ducman1998/basket-ball-robot/images/main_state_machine.png

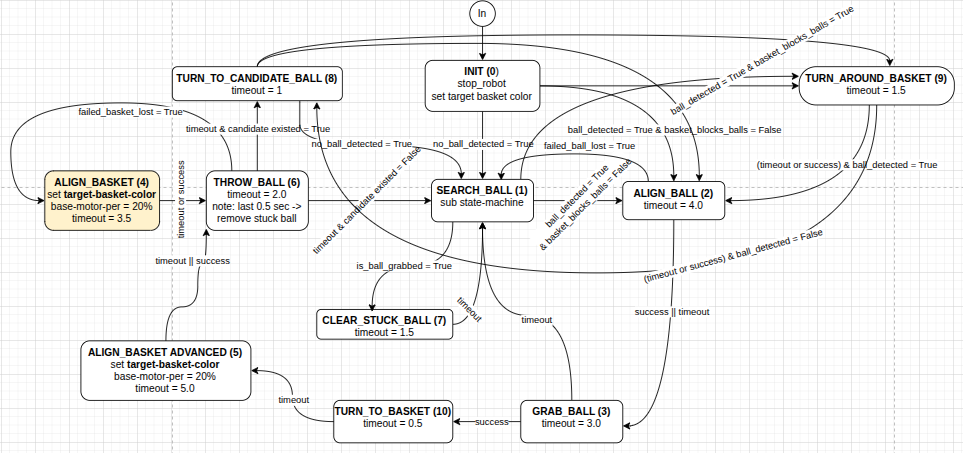
images/main_state_machine.png
