ducman1998/basket-ball-robot/images/searching_ball.png

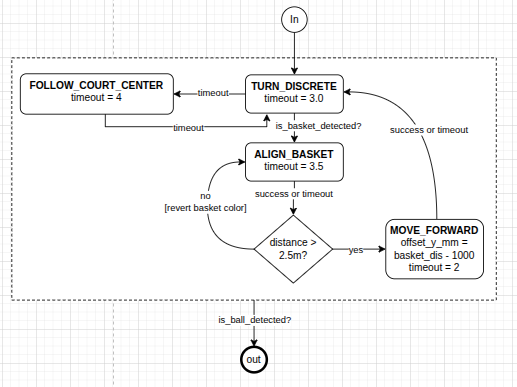
images/searching_ball.png
