ducman1998/basket-ball-robot/software/ros_nodes/src/basket_robot_nodes/basket_robot_nodes/images/robot_base_mask.png

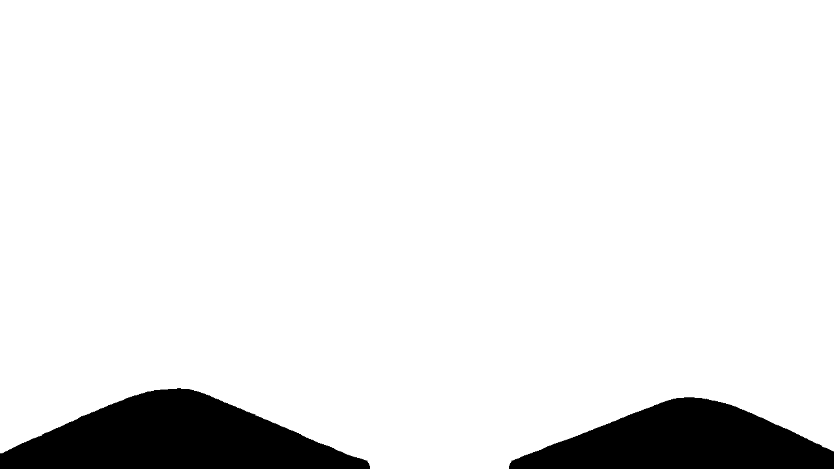
software/ros_nodes/src/basket_robot_nodes/basket_robot_nodes/images/robot_base_mask.png
