ducman1998/basket-ball-robot/electronics/picr_1_9tdi.kicad_pcb

## KiCad design electronics/picr_1_9tdi.kicad_pcb (2026-03-18)

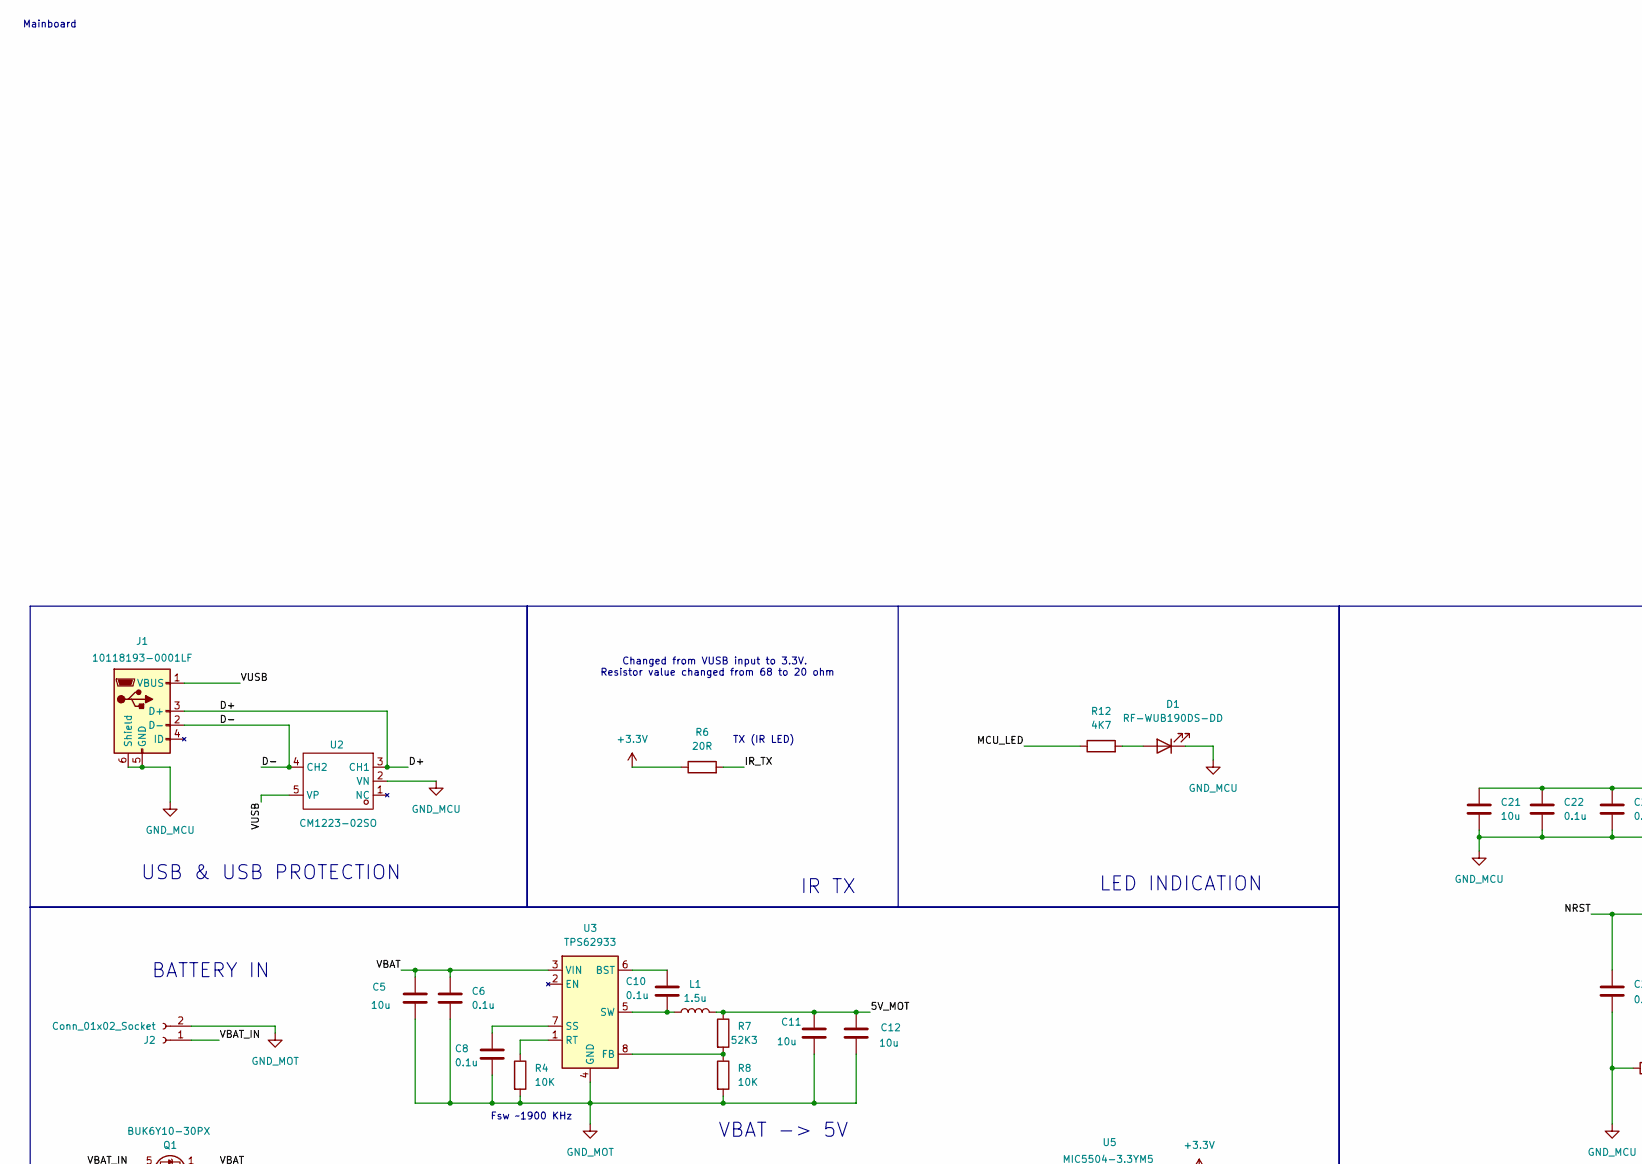
[picture p25: schematic picr_1_9tdi.kicad_sch, Mainboard & motor driver schematic, part in row 1, column 1]

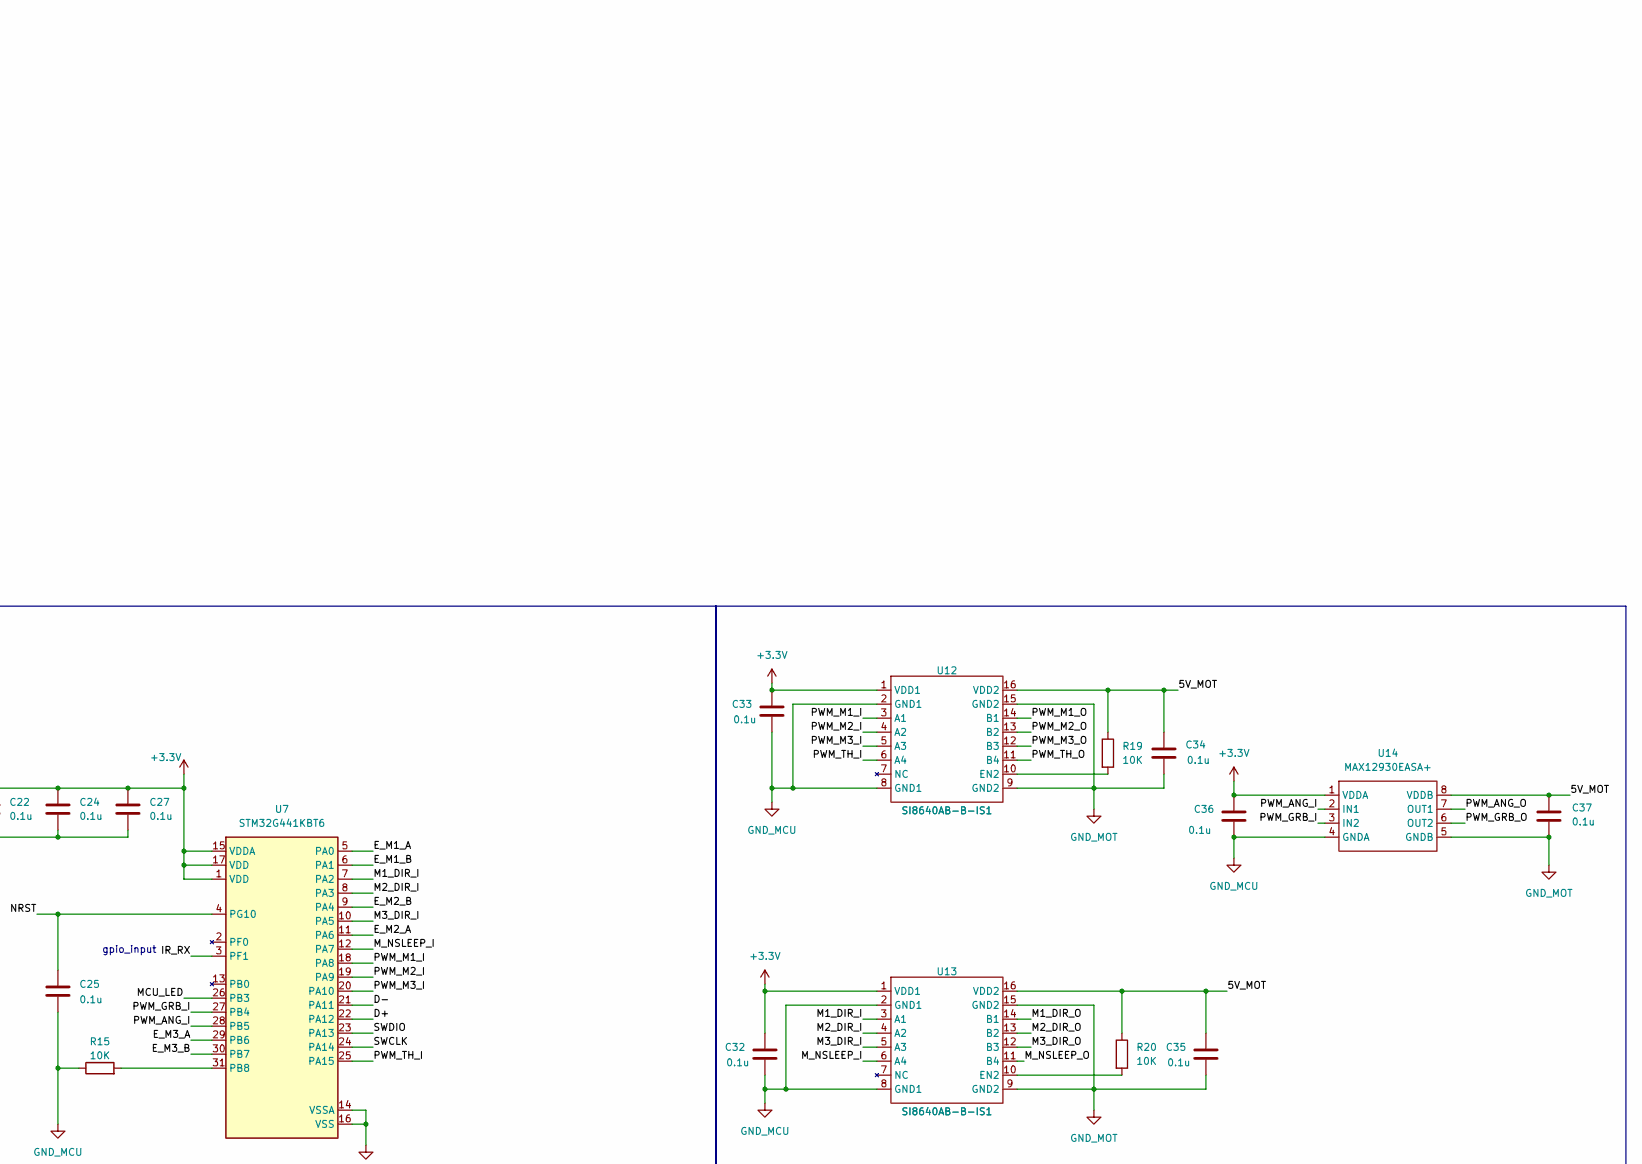
[picture p26: schematic picr_1_9tdi.kicad_sch, Mainboard & motor driver schematic, part in row 1, column 2]

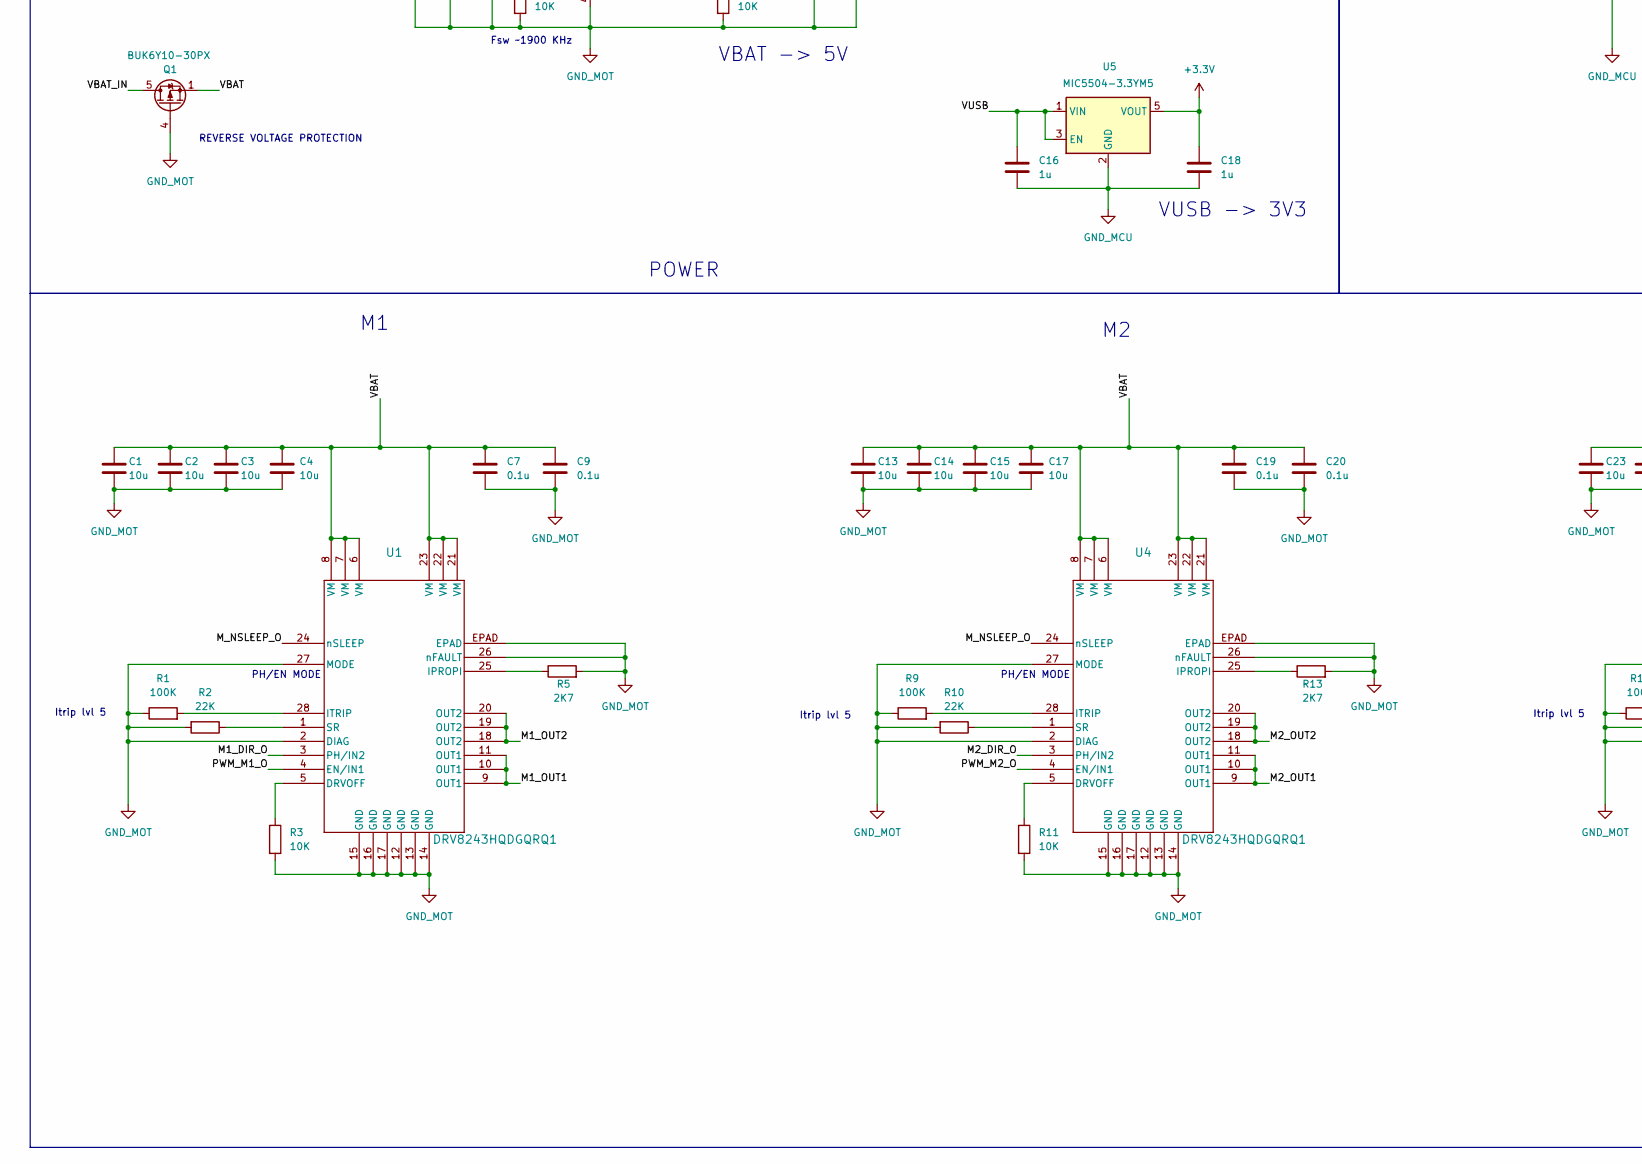
[picture p27: schematic picr_1_9tdi.kicad_sch, Mainboard & motor driver schematic, part in row 2, column 1]

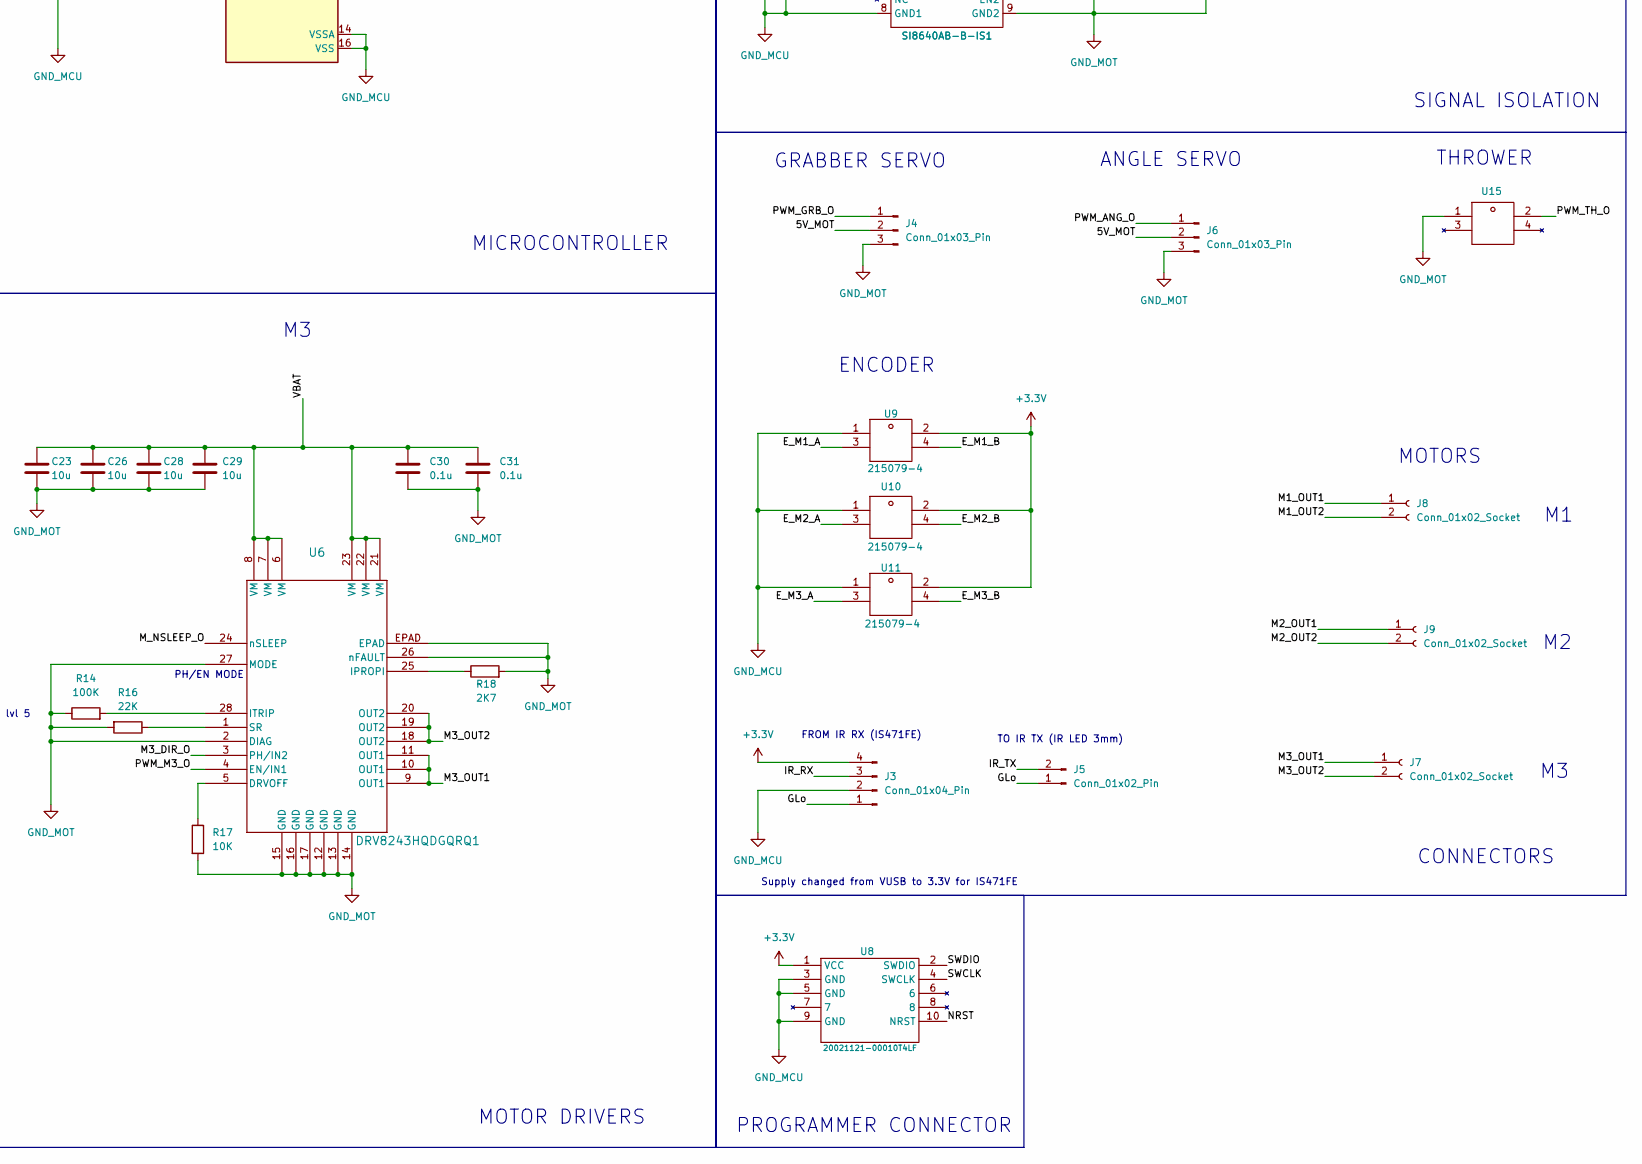
[picture p28: schematic picr_1_9tdi.kicad_sch, Mainboard & motor driver schematic, part in row 2, column 2]

Parts:
C1, C2, C3, C4, C5, C13, C14, C15, C17, C21, C23, C26, C28, C29: 10u; C_0805_2012Metric_Pad1.18x1.45mm_HandSolder
C6, C7, C8, C9, C10, C19, C20, C22, C24, C25, C27, C30, C31, C32, C33, C34, C35, C36, C37: 0.1u; C_0603_1608Metric_Pad1.08x0.95mm_HandSolder
C11, C12: 10u; C_0603_1608Metric_Pad1.08x0.95mm_HandSolder
C16, C18: 1u; C_0603_1608Metric_Pad1.08x0.95mm_HandSolder
D1: RF-WUB190DS-DD; LED_0603_1608Metric_Pad1.05x0.95mm_HandSolder
J1: 10118193-0001LF; USB_Micro-B_Amphenol_10118193-0001LF_Horizontal
J2: Conn_01x02_Socket; SolderWirePad_1x02_SMD_3x4mm_power
J3: Conn_01x04_Pin; PinHeader_1x04_P2.54mm_Vertical
J4, J6: Conn_01x03_Pin; PinHeader_1x03_P2.54mm_Vertical
J5: Conn_01x02_Pin; PinHeader_1x02_P2.54mm_Vertical
J7, J8, J9: Conn_01x02_Socket; SolderWirePad_1x02_SMD_3x4mm
L1: 1.5u; SRP4021HMCT-1R5M_custom
Q1: BUK6Y10-30PX
R1, R9, R14: 100K; R_0603_1608Metric_Pad0.98x0.95mm_HandSolder
R2, R10, R16: 22K; R_0603_1608Metric_Pad0.98x0.95mm_HandSolder
R3, R4, R8, R11, R15, R17, R19, R20: 10K; R_0603_1608Metric_Pad0.98x0.95mm_HandSolder
R5, R13, R18: 2K7; R_0603_1608Metric_Pad0.98x0.95mm_HandSolder
R6: 20R; R_0603_1608Metric_Pad0.98x0.95mm_HandSolder
R7: 52K3; R_0603_1608Metric_Pad0.98x0.95mm_HandSolder
R12: 4K7; R_0603_1608Metric_Pad0.98x0.95mm_HandSolder
U1, U4, U6: DRV8243HQDGQRQ1; VSSOP_SDGQQ1_TEX-L
U2: CM1223-02SO; SOT-23-5_L2.9-W1.6-P0.95-LS2.8-BR; Manufacturer Part CM1223-02SO; LCSC Part Name CM1223-02SO
U3: TPS62933; SOT-583-8
U5: MIC5504-3.3YM5; SOT-23-5
U7: STM32G441KBT6; LQFP-32_7x7mm_P0.8mm
U8: 20021121-00010T4LF; HDR-SMD_10P-P1.27-V-M-R2-C5-S1.27-LS5.5; Manufacturer Part 20021121-00010T4LF; LCSC Part Name 间距:1.27mm 立贴
U9, U10, U11: 215079-4; TE_Micro-MaTch_215079-4_2x02_P1.27mm_Vertical; Manufacturer Part 215079-4; LCSC Part Name 215079-4
U12, U13: SI8640AB-B-IS1; Manufacturer Part SI8640AB-B-IS1; LCSC Part Name SI8640AB-B-IS1
U14: MAX12930EASA+; SOIC-8_L4.9-W3.9-P1.27-LS6.0-BL; Manufacturer Part MAX12930EASA+; LCSC Part Name MAX12930EASA+
U15: TE_Micro-MaTch_215079-4_2x02_P1.27mm_Vertical; Manufacturer Part 215079-4; LCSC Part Name 215079-4

Connections:
+3.3V: C18.1, C21.1, C22.1, C24.1, C27.1, C32.1, C33.1, C36.1, J3.4, R6.1, U5.5 (VOUT), U7.1 (VDD), U7.15 (VDDA), U7.17 (VDD), U8.1 (VCC), U9.2, U10.2, U11.2, U12.1 (VDD1), U13.1 (VDD1), U14.1 (VDDA)
/5V_MOT: C11.1, C12.1, C34.1, C35.1, C37.1, J4.2, J6.2, L1.2, R7.1, R19.1, R20.1, U12.16 (VDD2), U13.16 (VDD2), U14.8 (VDDB)
/D+: J1.3 (D+), U2.3 (CH1), U7.22 (PA12)
/D-: J1.2 (D-), U2.4 (CH2), U7.21 (PA11)
/E_M1_A: U7.5 (PA0), U9.3
/E_M1_B: U7.6 (PA1), U9.4
/E_M2_A: U7.11 (PA6), U10.3
/E_M2_B: U7.9 (PA4), U10.4
/E_M3_A: U7.29 (PB6), U11.3
/E_M3_B: U7.30 (PB7), U11.4
/GLo: J3.1, J5.1
/IR_RX: J3.3, U7.3 (PF1)
/IR_TX: J5.2, R6.2
/M1_DIR_I: U7.7 (PA2), U13.3 (A1)
/M1_DIR_O: U1.3 (PH/IN2), U13.14 (B1)
/M1_OUT1: J8.1, U1.9 (OUT1), U1.10 (OUT1), U1.11 (OUT1)
/M1_OUT2: J8.2, U1.18 (OUT2), U1.19 (OUT2), U1.20 (OUT2)
/M2_DIR_I: U7.8 (PA3), U13.4 (A2)
/M2_DIR_O: U4.3 (PH/IN2), U13.13 (B2)
/M2_OUT1: J9.1, U4.9 (OUT1), U4.10 (OUT1), U4.11 (OUT1)
/M2_OUT2: J9.2, U4.18 (OUT2), U4.19 (OUT2), U4.20 (OUT2)
/M3_DIR_I: U7.10 (PA5), U13.5 (A3)
/M3_DIR_O: U6.3 (PH/IN2), U13.12 (B3)
/M3_OUT1: J7.1, U6.9 (OUT1), U6.10 (OUT1), U6.11 (OUT1)
/M3_OUT2: J7.2, U6.18 (OUT2), U6.19 (OUT2), U6.20 (OUT2)
/MCU_LED: R12.1, U7.26 (PB3)
/M_NSLEEP_I: U7.12 (PA7), U13.6 (A4)
/M_NSLEEP_O: U1.24 (nSLEEP), U4.24 (nSLEEP), U6.24 (nSLEEP), U13.11 (B4)
/NRST: C25.1, U7.4 (PG10), U8.10 (NRST)
/PWM_ANG_I: U7.28 (PB5), U14.2 (IN1)
/PWM_ANG_O: J6.1, U14.7 (OUT1)
/PWM_GRB_I: U7.27 (PB4), U14.3 (IN2)
/PWM_GRB_O: J4.1, U14.6 (OUT2)
/PWM_M1_I: U7.18 (PA8), U12.3 (A1)
/PWM_M1_O: U1.4 (EN/IN1), U12.14 (B1)
/PWM_M2_I: U7.19 (PA9), U12.4 (A2)
/PWM_M2_O: U4.4 (EN/IN1), U12.13 (B2)
/PWM_M3_I: U7.20 (PA10), U12.5 (A3)
/PWM_M3_O: U6.4 (EN/IN1), U12.12 (B3)
/PWM_TH_I: U7.25 (PA15), U12.6 (A4)
/PWM_TH_O: U12.11 (B4), U15.2
/SWCLK: U7.24 (PA14), U8.4 (SWCLK)
/SWDIO: U7.23 (PA13), U8.2 (SWDIO)
/VBAT: C1.1, C2.1, C3.1, C4.1, C5.1, C6.1, C7.1, C9.1, C13.1, C14.1, C15.1, C17.1, C19.1, C20.1, C23.1, C26.1, C28.1, C29.1, C30.1, C31.1, Q1.1 (S), Q1.2 (S), Q1.3 (S), U1.6 (VM), U1.7 (VM), U1.8 (VM), U1.21 (VM), U1.22 (VM), U1.23 (VM), U3.3 (VIN), U4.6 (VM), U4.7 (VM), U4.8 (VM), U4.21 (VM), U4.22 (VM), U4.23 (VM), U6.6 (VM), U6.7 (VM), U6.8 (VM), U6.21 (VM), U6.22 (VM), U6.23 (VM)
/VBAT_IN: J2.1, Q1.5 (D)
/VUSB: C16.1, J1.1 (VBUS), U2.5 (VP), U5.1 (VIN), U5.3 (EN)
GND_MCU: C16.2, C18.2, C21.2, C22.2, C24.2, C25.2, C27.2, C32.2, C33.2, C36.2, D1.1 (K), J1.5 (GND), J1.6 (Shield), J3.2, R15.1, U2.2 (VN), U5.2 (GND), U7.14 (VSSA), U7.16 (VSS), U7.32 (VSS), U8.3 (GND), U8.5 (GND), U8.9 (GND), U9.1, U10.1, U11.1, U12.2 (GND1), U12.8 (GND1), U13.2 (GND1), U13.8 (GND1), U14.4 (GNDA)
GND_MOT: C1.2, C2.2, C3.2, C4.2, C5.2, C6.2, C7.2, C8.2, C9.2, C11.2, C12.2, C13.2, C14.2, C15.2, C17.2, C19.2, C20.2, C23.2, C26.2, C28.2, C29.2, C30.2, C31.2, C34.2, C35.2, C37.2, J2.2, J4.3, J6.3, Q1.4 (G), R1.1, R2.2, R3.2, R4.2, R5.2, R8.2, R9.1, R10.2, R11.2, R13.2, R14.1, R16.2, R17.2, R18.2, U1.2 (DIAG), U1.12 (GND), U1.13 (GND), U1.14 (GND), U1.15 (GND), U1.16 (GND), U1.17 (GND), U1.26 (nFAULT), U1.27 (MODE), U1.EPAD, U3.4 (GND), U4.2 (DIAG), U4.12 (GND), U4.13 (GND), U4.14 (GND), U4.15 (GND), U4.16 (GND), U4.17 (GND), U4.26 (nFAULT), U4.27 (MODE), U4.EPAD, U6.2 (DIAG), U6.12 (GND), U6.13 (GND), U6.14 (GND), U6.15 (GND), U6.16 (GND), U6.17 (GND), U6.26 (nFAULT), U6.27 (MODE), U6.EPAD, U12.9 (GND2), U12.15 (GND2), U13.9 (GND2), U13.15 (GND2), U14.5 (GNDB), U15.1
unnamed: D1.2 (A), R12.2
unnamed: R3.1, U1.5 (DRVOFF)
unnamed: R5.1, U1.25 (IPROPI)
unnamed: R1.2, U1.28 (ITRIP)
unnamed: R2.1, U1.1 (SR)
unnamed: C10.1, U3.6 (BST)
unnamed: R7.2, R8.1, U3.8 (FB)
unnamed: R4.1, U3.1 (RT)
unnamed: C8.1, U3.7 (SS)
unnamed: C10.2, L1.1, U3.5 (SW)
unnamed: R11.1, U4.5 (DRVOFF)
unnamed: R13.1, U4.25 (IPROPI)
unnamed: R9.2, U4.28 (ITRIP)
unnamed: R10.1, U4.1 (SR)
unnamed: R17.1, U6.5 (DRVOFF)
unnamed: R18.1, U6.25 (IPROPI)
unnamed: R14.2, U6.28 (ITRIP)
unnamed: R16.1, U6.1 (SR)
unnamed: R15.2, U7.31 (PB8)
unnamed: R19.2, U12.10 (EN2)
unnamed: R20.2, U13.10 (EN2)

Notes on the sheet:
PH/EN MODE
VUSB -> 3V3
THROWER
TO IR TX (IR LED 3mm)
Fsw ~1900 KHz
Itrip lvl 5
Supply changed from VUSB to 3.3V for IS471FE
gpio_input
GRABBER SERVO
POWER
VBAT -> 5V
REVERSE VOLTAGE PROTECTION
ANGLE SERVO
ENCODER
MOTOR DRIVERS
PROGRAMMER CONNECTOR
LED INDICATION
SIGNAL ISOLATION
IR TX
MOTORS
TX (IR LED)
FROM IR RX (IS471FE)
Changed from VUSB input to 3.3V. Resistor value changed from 68 to 20 ohm
MICROCONTROLLER
CONNECTORS
Mainboard
BATTERY IN
USB & USB PROTECTION

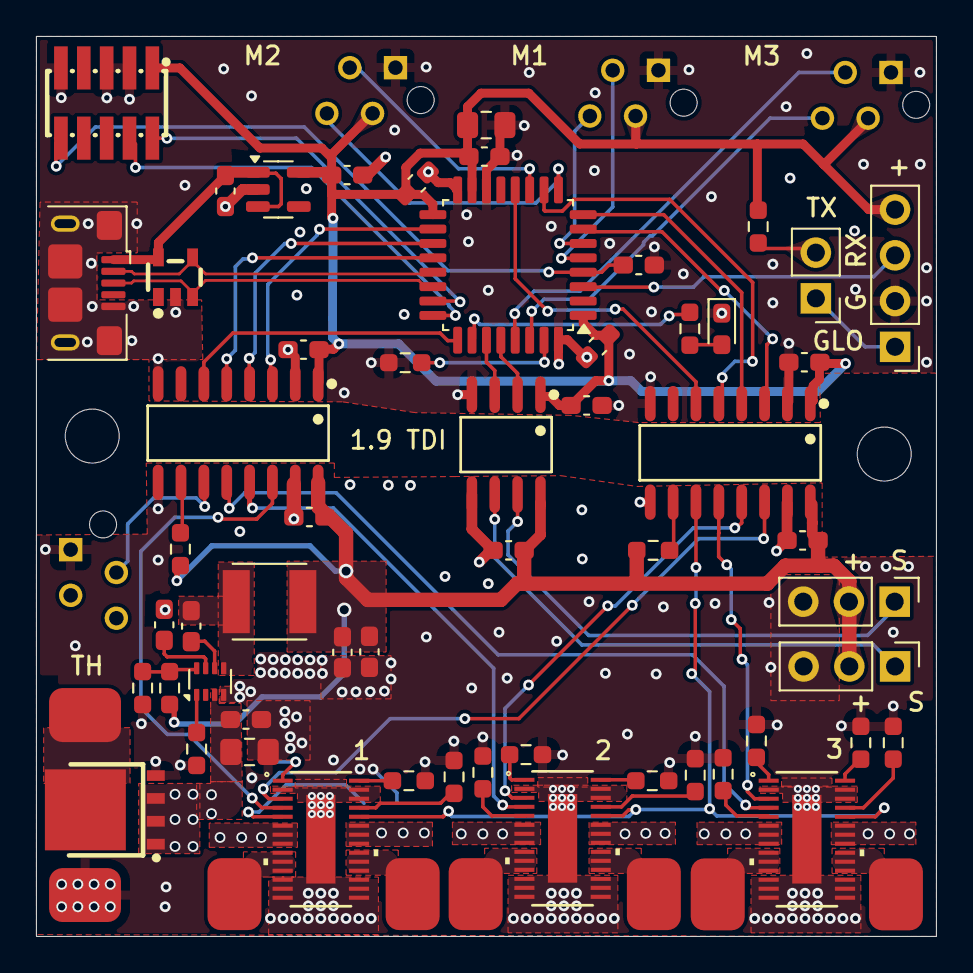
[picture p29: board picr_1_9tdi.kicad_pcb from above]

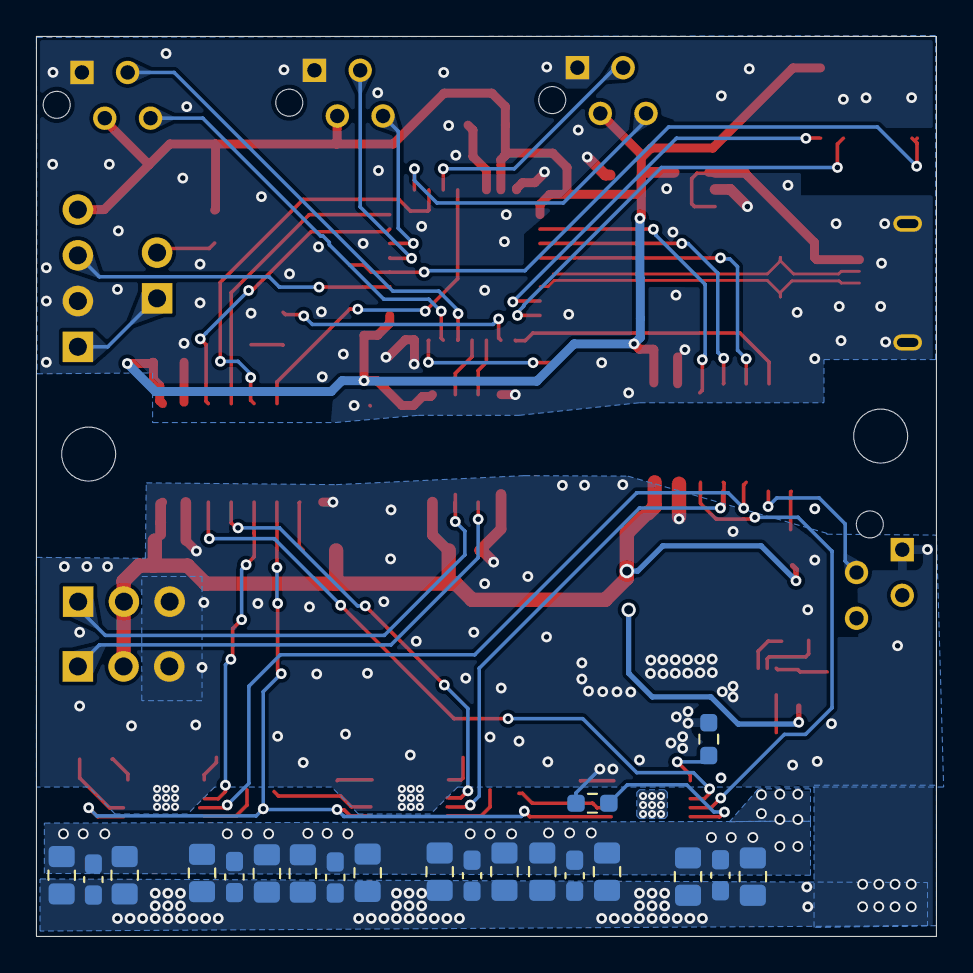
[picture p30: board picr_1_9tdi.kicad_pcb from below]

Board: 4 copper layers, 50.0 x 50.0 mm, 84 parts (20 on the bottom side), 69 nets.
