ducman1998/basket-ball-robot/firmware/Core/Src/main.c

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
/* Includes ------------------------------------------------------------------*/
#include "main.h"
#include "usb_device.h"

/* USER CODE BEGIN Includes */
#include "usbd_cdc_if.h"
/* USER CODE END Includes */

ADC_HandleTypeDef hadc2;

TIM_HandleTypeDef htim1;
TIM_HandleTypeDef htim2;
TIM_HandleTypeDef htim3;
TIM_HandleTypeDef htim4;
TIM_HandleTypeDef htim6;
TIM_HandleTypeDef htim8;
TIM_HandleTypeDef htim16;
TIM_HandleTypeDef htim17;

void SystemClock_Config(void);
static void MX_GPIO_Init(void);
static void MX_ADC2_Init(void);
static void MX_TIM1_Init(void);
static void MX_TIM2_Init(void);
static void MX_TIM3_Init(void);
static void MX_TIM4_Init(void);
static void MX_TIM6_Init(void);
static void MX_TIM8_Init(void);
static void MX_TIM16_Init(void);
static void MX_TIM17_Init(void);
/* USER CODE BEGIN 0 */
typedef struct Command{
  int16_t speed1;
  int16_t speed2;
  int16_t speed3;
  uint16_t throwerSpeed;
  uint16_t delimiter;
} Command;

Command command = {
    .speed1 = 0,
    .speed2 = 0,
    .speed3 = 0,
    .throwerSpeed = 0,
    .delimiter = 0
};
typedef struct Feedback {
  int16_t speed1;
  int16_t speed2;
  int16_t speed3;
  uint16_t delimiter;
} Feedback;

Feedback feedback = { .speed1 = 0, .speed2 = 0, .speed3 = 0, .delimiter = 0xAAAA};

typedef struct MotorControl {
	int32_t dCount;
	uint32_t prevCount;
	uint32_t currentCount;
	int32_t integral;
} MotorControl;

MotorControl motor1 = {.dCount = 0, .prevCount = 0, .currentCount=0,.integral=0};
MotorControl motor2 = {.dCount = 0, .prevCount = 0, .currentCount=0,.integral=0};
MotorControl motor3 = {.dCount = 0, .prevCount = 0, .currentCount=0,.integral=0};

volatile uint8_t isCommandReceived = 0;


void CDC_On_Receive(uint8_t* buffer, uint32_t* length) {
  if (*length == sizeof(Command)) {
    memcpy(&command, buffer, sizeof(Command));

    if (command.delimiter == 0xAAAA) {
      isCommandReceived = 1;
    }
  }
}
static inline void DWT_Init(void)
{
    CoreDebug->DEMCR |= CoreDebug_DEMCR_TRCENA_Msk;
    DWT->CYCCNT = 0;
    DWT->CTRL |= DWT_CTRL_CYCCNTENA_Msk;
}

static inline void delay_us(uint32_t us)
{
    uint32_t start = DWT->CYCCNT;
    uint32_t cycles = us * 160;
    while ((DWT->CYCCNT - start) < cycles);
}

uint16_t mapThrower(uint16_t inputValue) {

	if (inputValue <= 48)  inputValue = 48;
	if (inputValue >= 2047) inputValue = 2047;

	return(uint16_t)(((uint32_t)(inputValue - 48) * 65305U) / (2047U - 48U));

}
void enable_drivers() {
		HAL_GPIO_WritePin(NSLEEP_GPIO_Port, NSLEEP_Pin, GPIO_PIN_RESET);
	    delay_us(15);
	    HAL_GPIO_WritePin(NSLEEP_GPIO_Port, NSLEEP_Pin, GPIO_PIN_SET);
	    HAL_Delay(5);
}
int32_t clamp(int32_t value, int32_t min_value, int32_t max_value) {
	if (value > max_value) return max_value;
	if (value < min_value) return min_value;
	return value;
}

void rapidBlink() {
    for (uint8_t i = 0; i < 11; i++) {
        HAL_GPIO_TogglePin(MCU_LED_GPIO_Port, MCU_LED_Pin);
        HAL_Delay(100);
    }
}

int32_t setMotor(MotorControl* motorControl, int16_t commandCount) {
	static float kp = 450.0f;
	static float ki = 50.0f;

	motorControl->dCount = motorControl->currentCount - motorControl->prevCount;
	motorControl->prevCount = motorControl->currentCount;

	int32_t error = (int32_t)commandCount - (int32_t)motorControl->dCount;

	float prop = kp*(float)error;
	motorControl->integral += (float)error;

	float output = prop + ((float)motorControl->integral*ki);

	output = clamp((int32_t)output,-7999,7999);

	return (int32_t)output;

}

void runMotor(int32_t pwm, volatile uint32_t *ccr, GPIO_TypeDef *dirPort,
	 uint16_t dirPin) {

	if (pwm >= 0) {
		*ccr = pwm;
		HAL_GPIO_WritePin(dirPort, dirPin, GPIO_PIN_SET);
	} else {
		*ccr = -pwm;
		HAL_GPIO_WritePin(dirPort, dirPin, GPIO_PIN_RESET);
	}
}
void HAL_TIM_PeriodElapsedCallback(TIM_HandleTypeDef *htim) {

	if (htim == &htim6) {

		motor1.currentCount = (int16_t)TIM2->CNT;
		motor2.currentCount = (int16_t)TIM3->CNT;
		motor3.currentCount = (int16_t)TIM4->CNT;

	    runMotor(setMotor(&motor1, command.speed1),&TIM1->CCR1,M1_DIR_GPIO_Port,M1_DIR_Pin);
	    runMotor(setMotor(&motor2, command.speed2),&TIM1->CCR2,M2_DIR_GPIO_Port,M2_DIR_Pin);
	    runMotor(setMotor(&motor3, command.speed3),&TIM1->CCR3,M3_DIR_GPIO_Port,M3_DIR_Pin);

	}
}


/* USER CODE END 0 */

/**
  * @brief  The application entry point.
  * @retval int
  */
int main(void)
{

  /* MCU Configuration--------------------------------------------------------*/

  /* Reset of all peripherals, Initializes the Flash interface and the Systick. */
  HAL_Init();

  /* Configure the system clock */
  SystemClock_Config();

  /* Initialize all configured peripherals */
  MX_GPIO_Init();
  MX_USB_Device_Init();
  MX_ADC2_Init();
  MX_TIM1_Init();
  MX_TIM2_Init();
  MX_TIM3_Init();
  MX_TIM4_Init();
  MX_TIM6_Init();
  MX_TIM8_Init();
  MX_TIM16_Init();
  MX_TIM17_Init();
  /* USER CODE BEGIN 2 */
  DWT_Init();

  HAL_GPIO_WritePin(NSLEEP_GPIO_Port, NSLEEP_Pin, GPIO_PIN_SET);
  HAL_Delay(100);

  HAL_TIM_Encoder_Start(&htim2, TIM_CHANNEL_1 | TIM_CHANNEL_2);
  HAL_TIM_Encoder_Start(&htim3, TIM_CHANNEL_1 | TIM_CHANNEL_2);
  HAL_TIM_Encoder_Start(&htim4, TIM_CHANNEL_1 | TIM_CHANNEL_2);

  HAL_TIM_Base_Start_IT(&htim6);

  enable_drivers();

  HAL_TIM_PWM_Start(&htim16, TIM_CHANNEL_1);
  HAL_TIM_PWM_Start(&htim1, TIM_CHANNEL_1);
  HAL_TIM_PWM_Start(&htim1, TIM_CHANNEL_2);
  HAL_TIM_PWM_Start(&htim1, TIM_CHANNEL_3);
  HAL_TIM_PWM_Start(&htim8, TIM_CHANNEL_1);

  TIM8->CCR1 = 3000; // Allows ESC to initiate

  rapidBlink();

  /* USER CODE END 2 */

  /* Infinite loop */
  /* USER CODE BEGIN WHILE */
  while (1)
  {
    /* USER CODE END WHILE */

	if (isCommandReceived) {
		isCommandReceived = 0;
		HAL_GPIO_TogglePin(MCU_LED_GPIO_Port, MCU_LED_Pin);
		feedback.speed1 = motor1.dCount;
		feedback.speed2 = motor2.dCount;
		feedback.speed3 = motor3.dCount;
		TIM8->CCR1 = mapThrower(command.throwerSpeed);
		CDC_Transmit_FS((uint8_t *)&feedback, sizeof(feedback));

	  }
    /* USER CODE BEGIN 3 */
  }
  /* USER CODE END 3 */
}

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
