ducman1998/basket-ball-robot/firmware/picr_1_9tdi.ioc

Mcu.UserName=STM32G441KBTx
PA0.GPIO_Label=E_M1_A
PA0.Signal=S_TIM2_CH1
PA1.GPIO_Label=E_M1_B
PA1.Signal=S_TIM2_CH2
PA10.GPIO_Label=PWM_M3
PA10.Signal=S_TIM1_CH3
PA11.Signal=USB_DM
PA12.Signal=USB_DP
PA13.Signal=SYS_JTMS-SWDIO
PA14.Signal=SYS_JTCK-SWCLK
PA15.GPIO_Label=PWM_TH
PA15.Signal=S_TIM8_CH1
PA2.GPIO_Label=M1_DIR
PA2.Signal=GPIO_Output
PA3.GPIO_Label=M2_DIR
PA3.Signal=GPIO_Output
PA4.GPIO_Label=E_M2_B
PA4.Signal=S_TIM3_CH2
PA5.GPIO_Label=M3_DIR
PA5.Signal=GPIO_Output
PA6.GPIO_Label=E_M2_A
PA6.Signal=S_TIM3_CH1
PA7.GPIO_Label=NSLEEP
PA7.Signal=GPIO_Output
PA8.GPIO_Label=PWM_M1
PA8.Signal=S_TIM1_CH1
PA9.GPIO_Label=PWM_M2
PA9.Signal=S_TIM1_CH2
PB3.GPIO_Label=MCU_LED
PB3.Signal=GPIO_Output
PB4.GPIO_Label=PWM_GRB
PB4.Signal=S_TIM16_CH1
PB5.GPIO_Label=PWM_ANG
PB5.Signal=S_TIM17_CH1
PB6.GPIO_Label=E_M3_A
PB6.Signal=S_TIM4_CH1
PB7.GPIO_Label=E_M3_B
PB7.Signal=S_TIM4_CH2
PF1-OSC_OUT.GPIO_Label=IR_RX
PF1-OSC_OUT.Signal=ADC2_IN10
