ducman1998/basket-ball-robot/(commit log)

2025-09-18 Added robot ommiwheel kinematics + mainboard communication
2025-09-18 Refactored code + added config file
    [robot_config.yaml]
2025-09-19 Added auto-scan serial port based on hardware ID
    [robot_config.yaml]
2025-09-26 Implemented Odometry node + modified base-controller node
2025-09-26 Updated documents for Odometry + Mainboard controller
2025-09-27 Updated Jacobian + Odometry logic
2025-09-27 Updated Edit ODOMETRY.asciidoc
2025-09-30 Upload New File
    [picr_1_9tdi.kicad_sch]
2025-10-01 Schem rev1
    [picr_1_9tdi.kicad_sch]
2025-10-04 Schem rev2
    [picr_1_9tdi.kicad_pcb, picr_1_9tdi.kicad_sch]
2025-10-05 Fixed logic error in image-processor node
    [setting.yaml]
2025-10-06 Updated PID params
2025-10-07 Schem rev3
    [picr_1_9tdi.kicad_pcb, picr_1_9tdi.kicad_sch]
2025-10-09 Changed print to logger.info
2025-10-11 Improved ball detection algorithm + Set a fixed exposure time for color cam
    [image_info.py, setting.yaml]
2025-10-11 Update 23 files
    - /electronics/picr_1_9tdi-backups/picr_1_9tdi-2025-09-23_205805/picr_1_9tdi.kicad_pcb
    - /electronics/picr_1_9tdi-backups/picr_1_9tdi-2025-09-23_205805/picr_1_9tdi.kicad_prl
    - /electronics/picr_1_9tdi-backups/picr_1_9tdi-2025-09-23_205805/picr_1_9tdi.kicad_pro
    - /electronics/picr_1_9tdi-backups/picr_1_9tdi-2025-09-23_205805/picr_1_9tdi.kicad_sch
    - /electronics/picr_1_9tdi-backups/picr_1_9tdi-2025-09-23_205805/untitled.kicad_sch
    - /electronics/picr_1_9tdi-backups/picr_1_9tdi-2025-10-07_171026.zip
    - /electronics/picr_1_9tdi-backups/picr_1_9tdi-2025-10-07_171826.zip
    - /electronics/picr_1_9tdi-backups/picr_1_9tdi-2025-10-07_172522.zip
    - /electronics/picr_1_9tdi-backups/picr_1_9td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
2025-10-14 Added robot-find-a-ball task logic, tighten ball detection threshold
2025-10-20 Revert "Merge branch 'robot_follow_a_ball' into 'software'"
    This reverts merge request !3
    [feedback.py, image_info.py, number_utils.py]
2025-10-22 Revert "Revert "Merge branch 'robot_follow_a_ball' into 'software'""
    This reverts commit 85a2163ec675d8f5c9c19424805a44d39aa4db20.
    [feedback.py, image_info.py, number_utils.py]
2025-10-31 Refactored PID params
2025-11-11 Replace 0.2/0.4 vias with 0.2/0.45 vias and adjust GND copper zone
    [picr_1_9tdi-B_Cu.gbr, picr_1_9tdi-B_GND.gbr, picr_1_9tdi-B_Mask.gbr, picr_1_9tdi-B_Paste.gbr, picr_1_9tdi-B_Silkscreen.gbr, picr_1_9tdi-Edge_Cuts.gbr, picr_1_9tdi-F_Cu.gbr, picr_1_9tdi-F_GND.gbr]
2025-12-10 Turn to pure-persuit look-like controller to force robot follow straight line (not work well, better than previous commit)
    [peripheral_manager.py]
2025-12-13 Fixed bug: basket alignment based on experimental offset
    [image_processing.py, setting.yaml]
2025-12-13 Set the distance to basket the same as current distanct to basket
2025-12-15 Clean state-machine, added ball-manager to store detected balls in odom frame
2025-12-15 Updated new calib thrower speed + fixed bug: robot ran behind the basket
    [image_processing.py]
2025-12-15 Fixed comments from Allan
    [base_game_logic.py, image_processing.py, peripheral_manager.py, robot_motion.py]
2025-12-18 Updated with new partial calibration
2026-01-10 Calibrated thrower percent + basket offset (finished)
